esden/glasgow-addons/hardware/ram-pak/ram-pak-sch.pdf

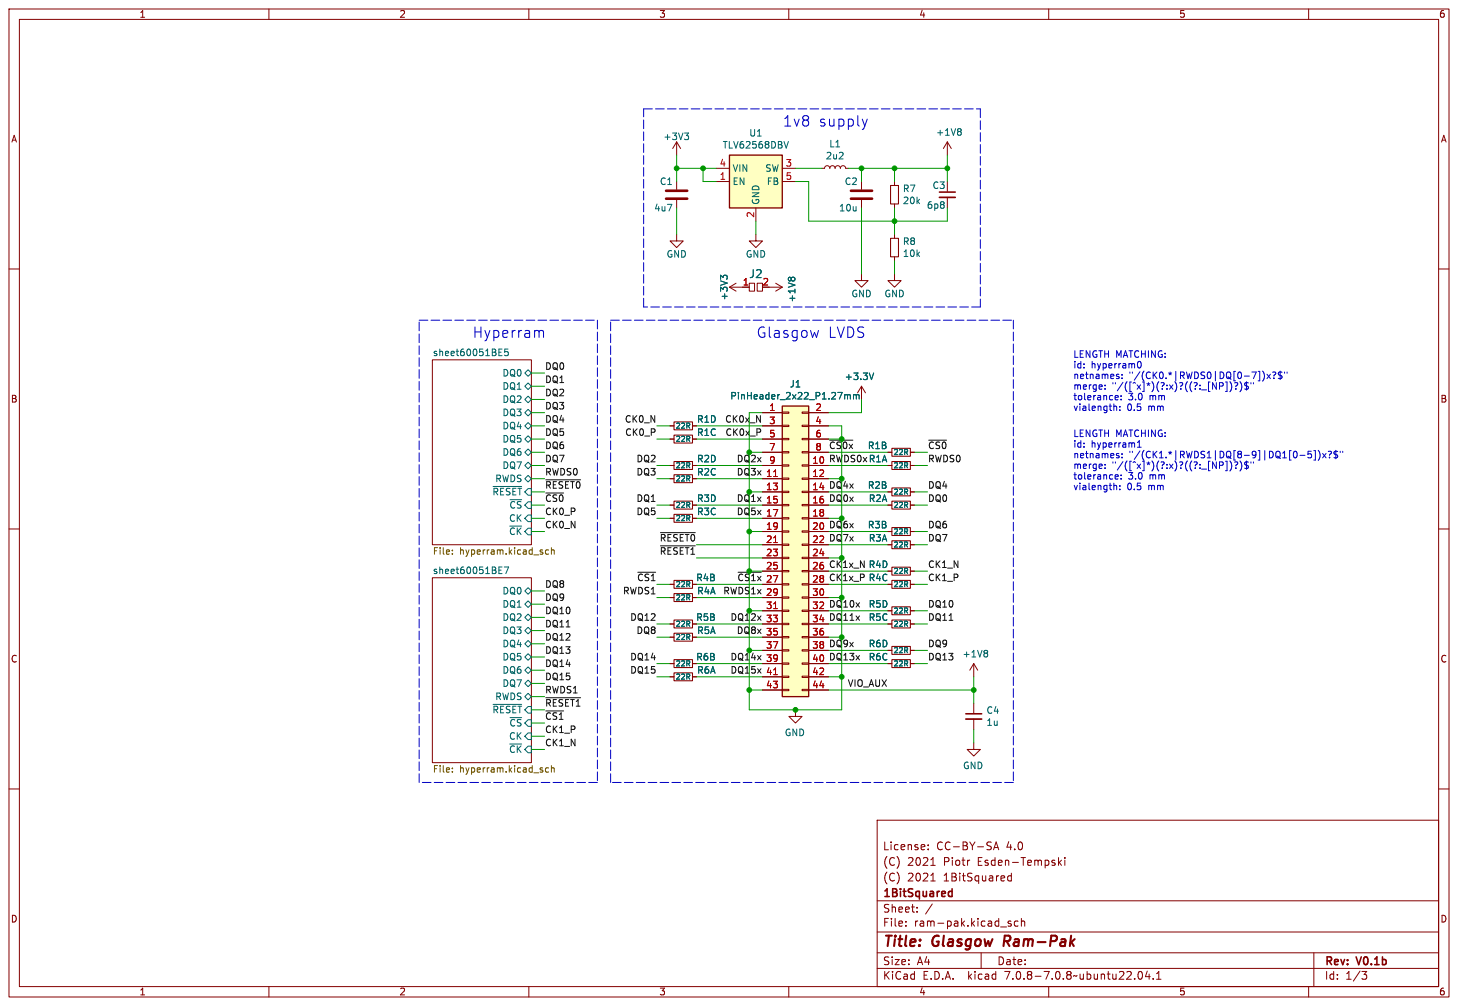
[picture p1: page 1]

File: ram-pak.kicad_sch Sheet: / 1BitSquared

Id: 1/3 Title: Glasgow Ram-Pak

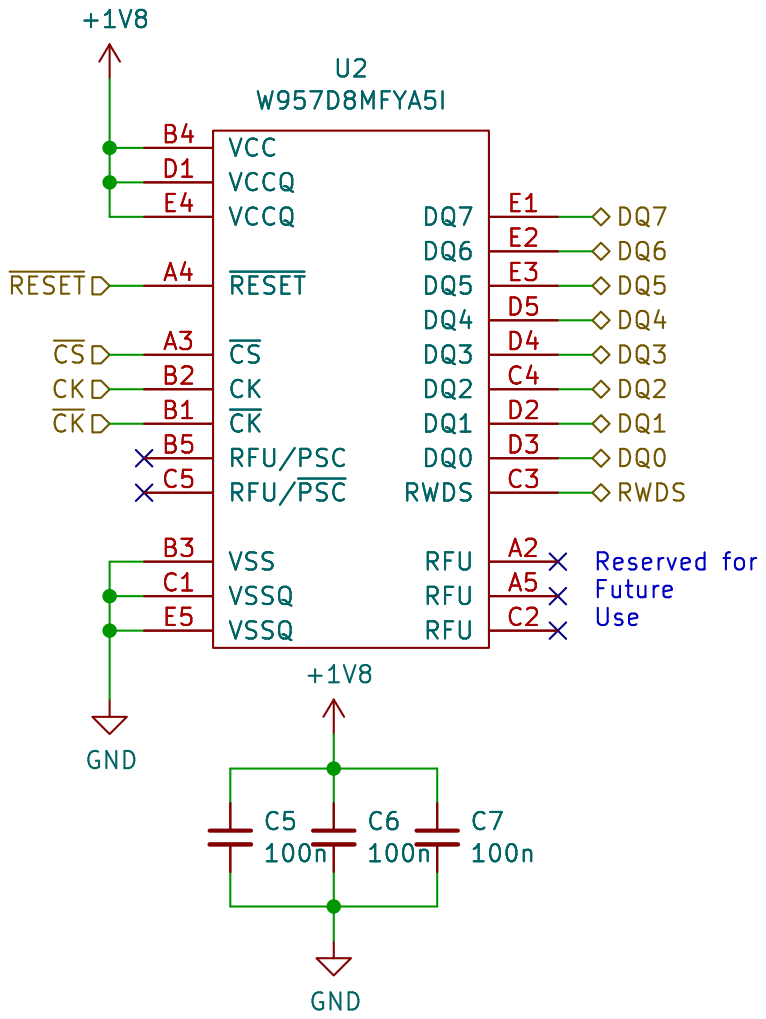
[picture p2: page 2]

Id: 2/3 Title: iCEBreaker PMOD - Hyperram

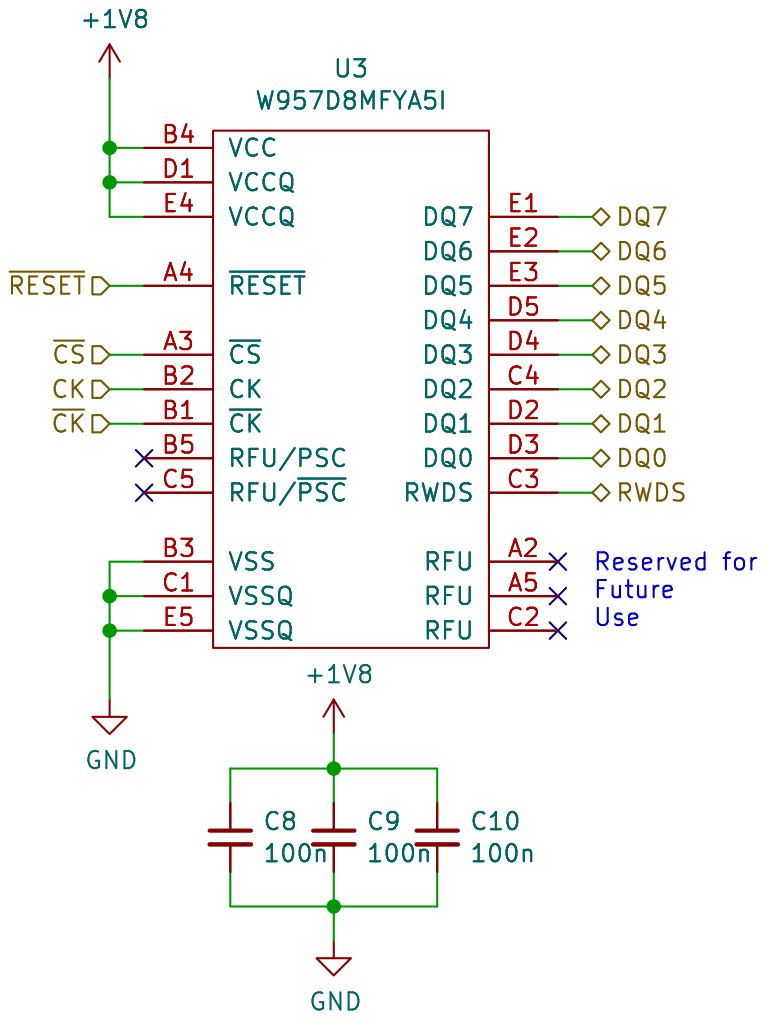
[picture p3: page 3]

Id: 3/3 Title: iCEBreaker PMOD - Hyperram
