esden/glasgow-addons/hardware/prom-addon/prom-addon-sch.pdf

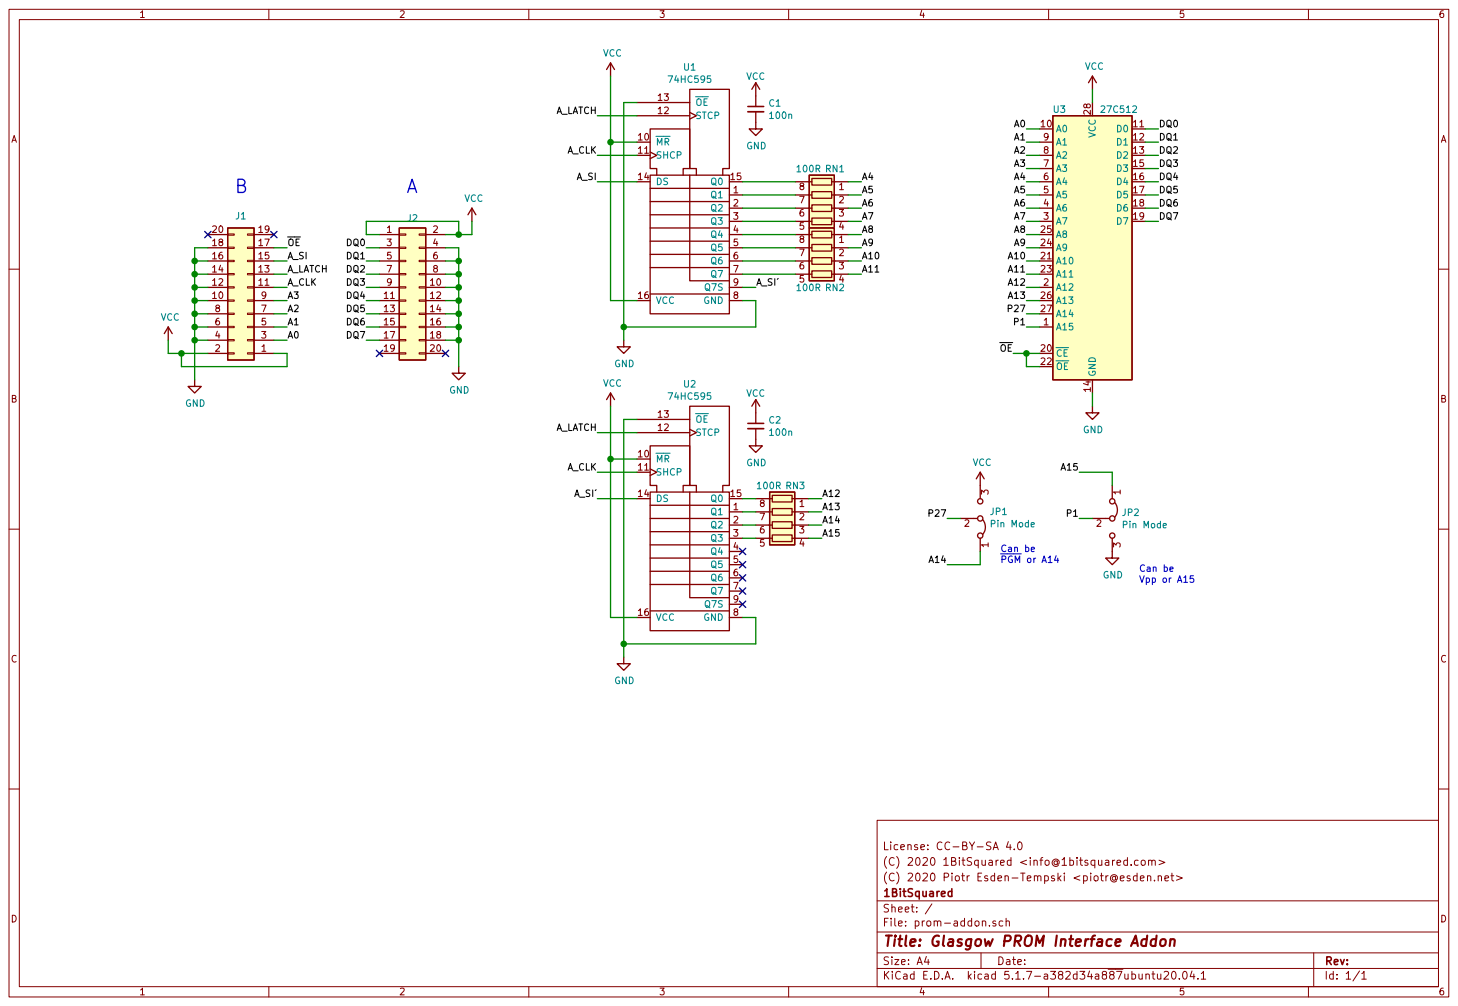
[picture p4: page 1]

License: CC-BY-SA 4.0 C2

(C) 2020 1BitSquared <info@1bitsquared.com>
(C) 2020 Piotr Esden-Tempski <piotr@esden.net>
File: prom-addon.sch Sheet: / 1BitSquared

Id: 1/1 Title: Glasgow PROM Interface Addon
