esden/glasgow-addons/hardware/ram-pak/ram-pak.kicad_pcb

## KiCad design hardware/ram-pak/ram-pak.kicad_pcb (2023-10-24)

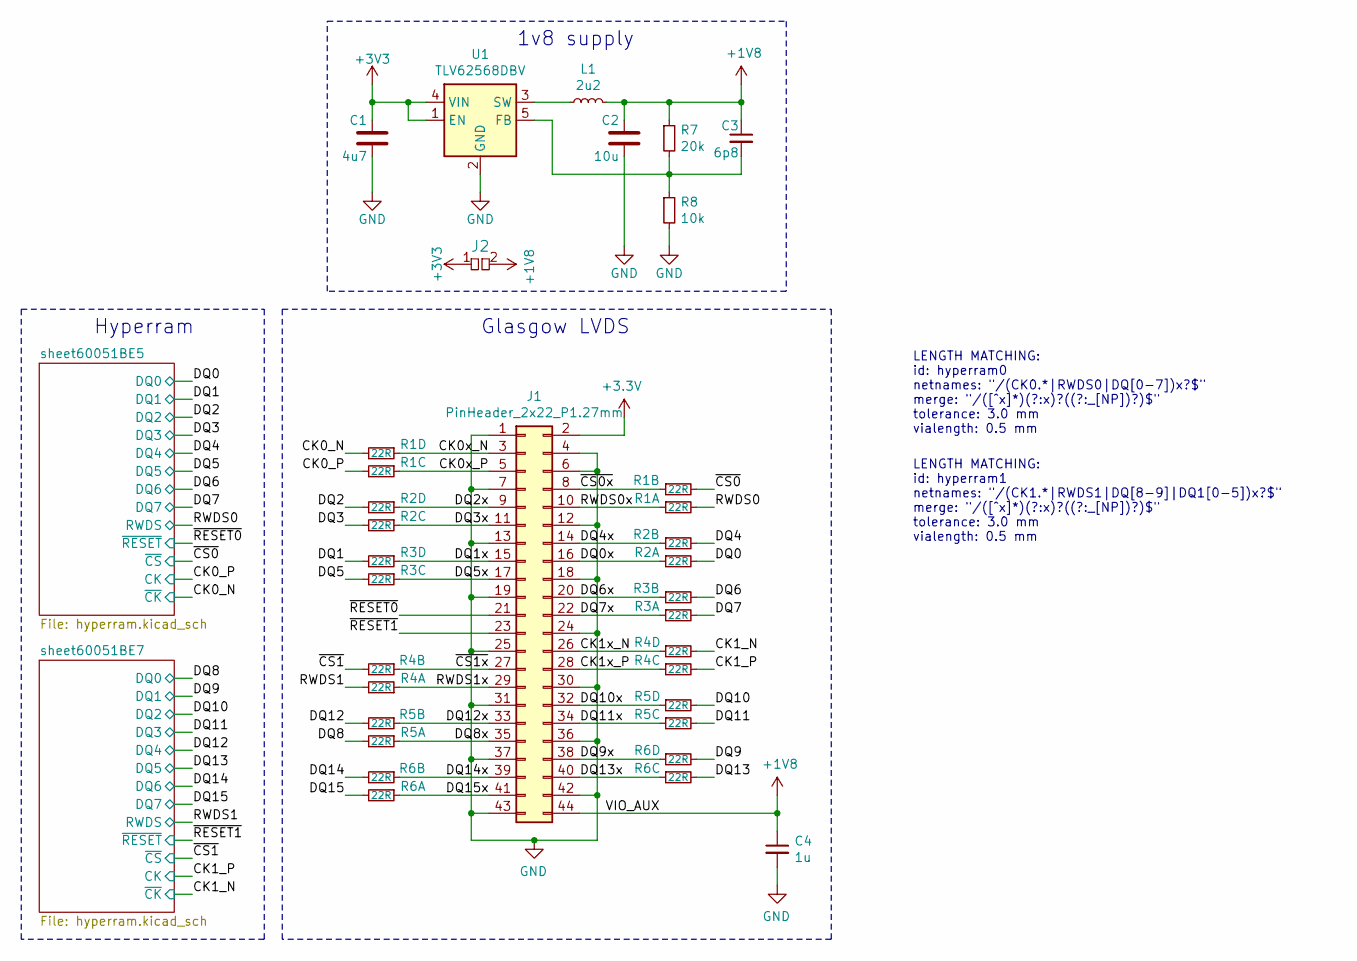
[picture p5: schematic ram-pak.kicad_sch, Glasgow Ram-Pak]

Parts:
C1: 4u7; C_0603
C2: 10u; C_0603
C3: 6p8; C_0402
C4: 1u; C_0402
J1: PinHeader_2x22_P1.27mm; PinSocket_2x22_P1.27mm_Vertical_Pass-Through__SMD; MPN FTS-122-01-L-DV
J2: pkl_jumper; J_0603
L1: 2u2; L_0805
R1, R2, R3, R4, R5, R6: 22R; R_Array_Convex_4x0402
R7: 20k; R_0402
R8: 10k; R_0402
U1: TLV62568DBV; SOT-23-5

Connections:
+1V8: C2.1, C3.1, C4.1, J1.44, J2.2, L1.1, R7.1; also elsewhere on the board
/CK0_N: R1.8; also elsewhere on the board
/CK0_P: R1.6; also elsewhere on the board
/CK0x_N: J1.3, R1.7
/CK0x_P: J1.5, R1.5
/CK1_N: R4.8; also elsewhere on the board
/CK1_P: R4.6; also elsewhere on the board
/CK1x_N: J1.26, R4.7
/CK1x_P: J1.28, R4.5
/DQ0: R2.2; also elsewhere on the board
/DQ0x: J1.16, R2.1
/DQ1: R3.8; also elsewhere on the board
/DQ1x: J1.15, R3.7
/DQ2: R2.8; also elsewhere on the board
/DQ2x: J1.9, R2.7
/DQ3: R2.6; also elsewhere on the board
/DQ3x: J1.11, R2.5
/DQ4: R2.4; also elsewhere on the board
/DQ4x: J1.14, R2.3
/DQ5: R3.6; also elsewhere on the board
/DQ5x: J1.17, R3.5
/DQ6: R3.4; also elsewhere on the board
/DQ6x: J1.20, R3.3
/DQ7: R3.2; also elsewhere on the board
/DQ7x: J1.22, R3.1
/DQ8: R5.2; also elsewhere on the board
/DQ8x: J1.35, R5.1
/DQ9: R6.8; also elsewhere on the board
/DQ9x: J1.38, R6.7
/DQ10: R5.8; also elsewhere on the board
/DQ10x: J1.32, R5.7
/DQ11: R5.6; also elsewhere on the board
/DQ11x: J1.34, R5.5
/DQ12: R5.4; also elsewhere on the board
/DQ12x: J1.33, R5.3
/DQ13: R6.6; also elsewhere on the board
/DQ13x: J1.40, R6.5
/DQ14: R6.4; also elsewhere on the board
/DQ14x: J1.39, R6.3
/DQ15: R6.2; also elsewhere on the board
/DQ15x: J1.41, R6.1
/RWDS0: R1.2; also elsewhere on the board
/RWDS0x: J1.10, R1.1
/RWDS1: R4.2; also elsewhere on the board
/RWDS1x: J1.29, R4.1
/~CS0x: J1.8, R1.3
/~CS0: R1.4; also elsewhere on the board
/~CS1x: J1.27, R4.3
/~CS1: R4.4; also elsewhere on the board
/~RESET0: J1.21; also elsewhere on the board
/~RESET1: J1.23; also elsewhere on the board
GND: C1.2, C2.2, C4.2, J1.1, J1.4, J1.6, J1.7, J1.12, J1.13, J1.18, J1.19, J1.24, J1.25, J1.30, J1.31, J1.36, J1.37, J1.42, J1.43, R8.2, U1.2 (GND); also elsewhere on the board
unnamed: C3.2, R7.2, R8.1, U1.5 (FB)
unnamed: L1.2, U1.3 (SW)

Notes on the sheet:
LENGTH MATCHING: id: hyperram0 netnames: "/(CK0.*|RWDS0|DQ[0-7])x?$" merge: "/([^x]*)(?:x)?((?:_[NP])?)$" tolerance: 3.0 mm vialength: 0.5 mm
Glasgow LVDS
LENGTH MATCHING: id: hyperram1 netnames: "/(CK1.*|RWDS1|DQ[8-9]|DQ1[0-5])x?$" merge: "/([^x]*)(?:x)?((?:_[NP])?)$" tolerance: 3.0 mm vialength: 0.5 mm
1v8 supply
Hyperram

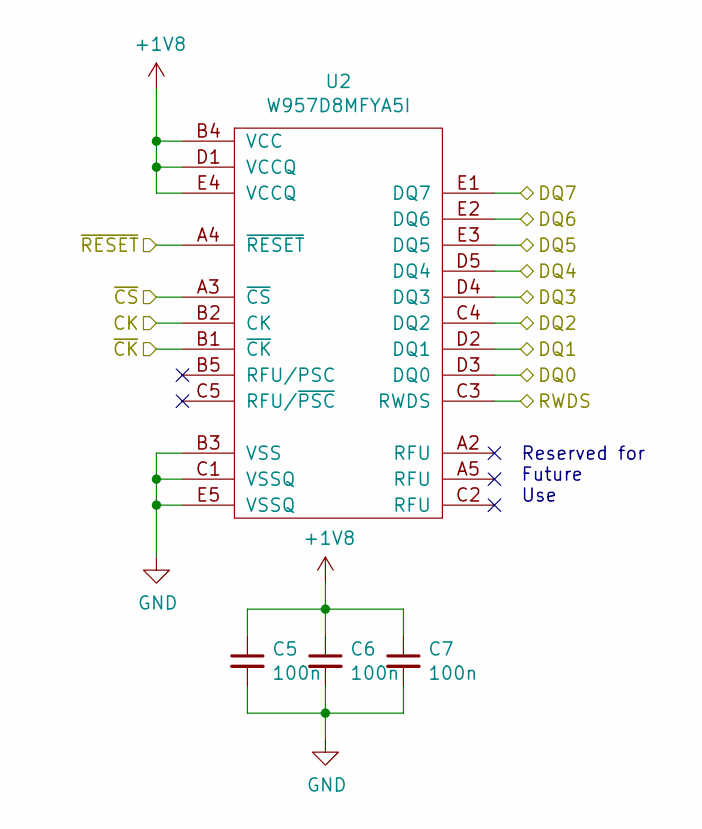
[picture p6: schematic hyperram.kicad_sch, iCEBreaker PMOD - Hyperram]

Parts:
C5, C6, C7: 100n; C_0402
U2: W957D8MFYA5I; BGA-24_5x5_6.0x8.0mm

Connections:
+1V8: C5.1, C6.1, C7.1, U2.B4 (VCC), U2.D1 (VCCQ), U2.E4 (VCCQ); also elsewhere on the board
/CK0_N: U2.B1 (~CK); also elsewhere on the board
/CK0_P: U2.B2 (CK); also elsewhere on the board
/DQ0: U2.D3 (DQ0); also elsewhere on the board
/DQ1: U2.D2 (DQ1); also elsewhere on the board
/DQ2: U2.C4 (DQ2); also elsewhere on the board
/DQ3: U2.D4 (DQ3); also elsewhere on the board
/DQ4: U2.D5 (DQ4); also elsewhere on the board
/DQ5: U2.E3 (DQ5); also elsewhere on the board
/DQ6: U2.E2 (DQ6); also elsewhere on the board
/DQ7: U2.E1 (DQ7); also elsewhere on the board
/RWDS0: U2.C3 (RWDS); also elsewhere on the board
/~CS0: U2.A3 (~CS); also elsewhere on the board
/~RESET0: U2.A4 (~RESET); also elsewhere on the board
GND: C5.2, C6.2, C7.2, U2.B3 (VSS), U2.C1 (VSSQ), U2.E5 (VSSQ); also elsewhere on the board

Parts of its further copies:
C8, C9, C10: 100n; C_0402
U3: W957D8MFYA5I; BGA-24_5x5_6.0x8.0mm

Connections of its further copies:
+1V8: C8.1, C9.1, C10.1, U3.B4 (VCC), U3.D1 (VCCQ), U3.E4 (VCCQ); also elsewhere on the board
/CK1_N: U3.B1 (~CK); also elsewhere on the board
/CK1_P: U3.B2 (CK); also elsewhere on the board
/DQ8: U3.D3 (DQ0); also elsewhere on the board
/DQ9: U3.D2 (DQ1); also elsewhere on the board
/DQ10: U3.C4 (DQ2); also elsewhere on the board
/DQ11: U3.D4 (DQ3); also elsewhere on the board
/DQ12: U3.D5 (DQ4); also elsewhere on the board
/DQ13: U3.E3 (DQ5); also elsewhere on the board
/DQ14: U3.E2 (DQ6); also elsewhere on the board
/DQ15: U3.E1 (DQ7); also elsewhere on the board
/RWDS1: U3.C3 (RWDS); also elsewhere on the board
/~CS1: U3.A3 (~CS); also elsewhere on the board
/~RESET1: U3.A4 (~RESET); also elsewhere on the board
GND: C8.2, C9.2, C10.2, U3.B3 (VSS), U3.C1 (VSSQ), U3.E5 (VSSQ); also elsewhere on the board

Notes on the sheet:
Reserved for Future Use

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
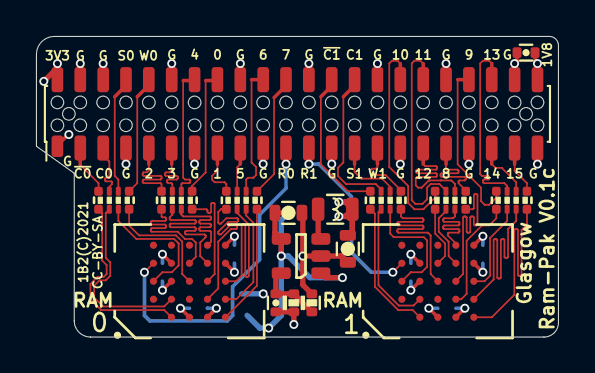
[picture p7: board ram-pak.kicad_pcb from above]

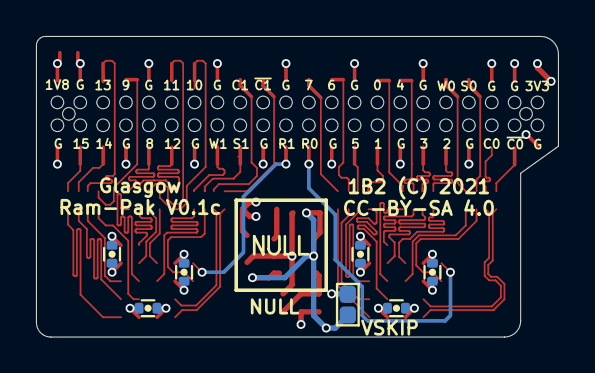
[picture p8: board ram-pak.kicad_pcb from below]

Board: 4 copper layers, 29.0 x 16.7 mm, 24 parts (7 on the bottom side), 55 nets.
