esden/glasgow-addons/hardware/prom-addon/prom-addon.kicad_pcb

## KiCad design hardware/prom-addon/prom-addon.kicad_pcb (2021-01-18)

Schematic: prom-addon.sch, Glasgow PROM Interface Addon

Parts:
C1, C2: 100n; C_0402
J1, J2: Conn_02x10_Odd_Even; PinSocket_2x10_P2.54mm_Vertical
JP1, JP2: Pin Mode; PinHeader_1x03_P2.54mm_Vertical
RN1, RN2, RN3: 33R; R_Array_Convex_4x0402
U1, U2: 74HC595; DHVQFN-16_2.5x3.5mm_Pitch0.5mm
U3: 27C512; DIP-28_W15.24mm

Connections:
/A0: J1.3, U3.10 (A0)
/A1: J1.5, U3.9 (A1)
/A2: J1.7, U3.8 (A2)
/A3: J1.9, U3.7 (A3)
/A4: RN1.1 (R1.1), U3.6 (A4)
/A5: RN1.2 (R2.1), U3.5 (A5)
/A6: RN1.3 (R3.1), U3.4 (A6)
/A7: RN1.4 (R4.1), U3.3 (A7)
/A8: RN2.1 (R1.1), U3.25 (A8)
/A9: RN2.2 (R2.1), U3.24 (A9)
/A10: RN2.3 (R3.1), U3.21 (A10)
/A11: RN2.4 (R4.1), U3.23 (A11)
/A12: RN3.1 (R1.1), U3.2 (A12)
/A13: RN3.2 (R2.1), U3.26 (A13)
/A14: JP1.1 (A), RN3.3 (R3.1)
/A15: JP2.1 (A), RN3.4 (R4.1)
/A_CLK: J1.11, U1.11, U2.11
/A_LATCH: J1.13, U1.12, U2.12
/A_SI: J1.15, U1.14
/A_SI´: U1.9, U2.14
/DQ0: J2.3, U3.11 (D0)
/DQ1: J2.5, U3.12 (D1)
/DQ2: J2.7, U3.13 (D2)
/DQ3: J2.9, U3.15 (D3)
/DQ4: J2.11, U3.16 (D4)
/DQ5: J2.13, U3.17 (D5)
/DQ6: J2.15, U3.18 (D6)
/DQ7: J2.17, U3.19 (D7)
/P1: JP2.2 (C), U3.1 (A15)
/P27: JP1.2 (C), U3.27 (A14)
/~OE: J1.17, U3.20 (~CE), U3.22 (~OE)
GND: C1.2, C2.2, J1.4, J1.6, J1.8, J1.10, J1.12, J1.14, J1.16, J1.18, J2.4, J2.6, J2.8, J2.10, J2.12, J2.14, J2.16, J2.18, JP2.3 (B), U1.8, U1.13, U1.17, U2.8, U2.13, U2.17, U3.14 (GND)
unnamed: RN1.5 (R4.2), U1.3
unnamed: RN1.6 (R3.2), U1.2
unnamed: RN1.7 (R2.2), U1.1
unnamed: RN1.8 (R1.2), U1.15
unnamed: RN2.5 (R4.2), U1.7
unnamed: RN2.6 (R3.2), U1.6
unnamed: RN2.7 (R2.2), U1.5
unnamed: RN2.8 (R1.2), U1.4
unnamed: RN3.5 (R4.2), U2.3
unnamed: RN3.6 (R3.2), U2.2
unnamed: RN3.7 (R2.2), U2.1
unnamed: RN3.8 (R1.2), U2.15
VCC: C1.1, C2.1, J1.1, J1.2, J2.1, J2.2, JP1.3 (B), U1.10, U1.16, U2.10, U2.16, U3.28 (VCC)

Notes on the sheet:
Can be ~PGM~ or A14
Can be Vpp or A15

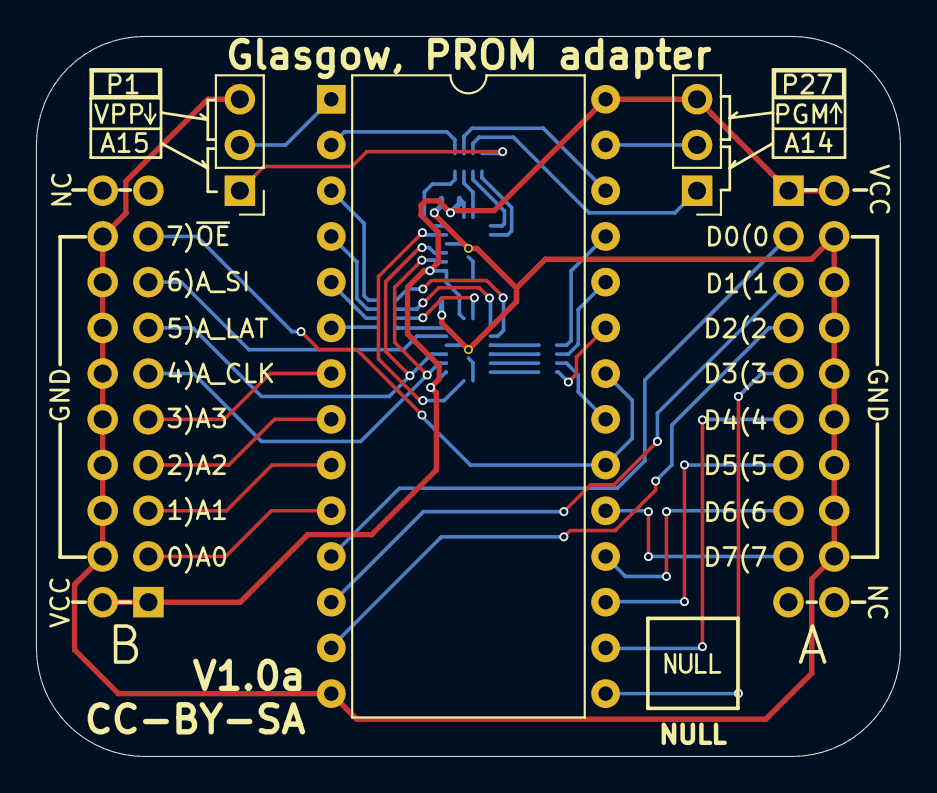
[picture p9: board prom-addon.kicad_pcb from above]

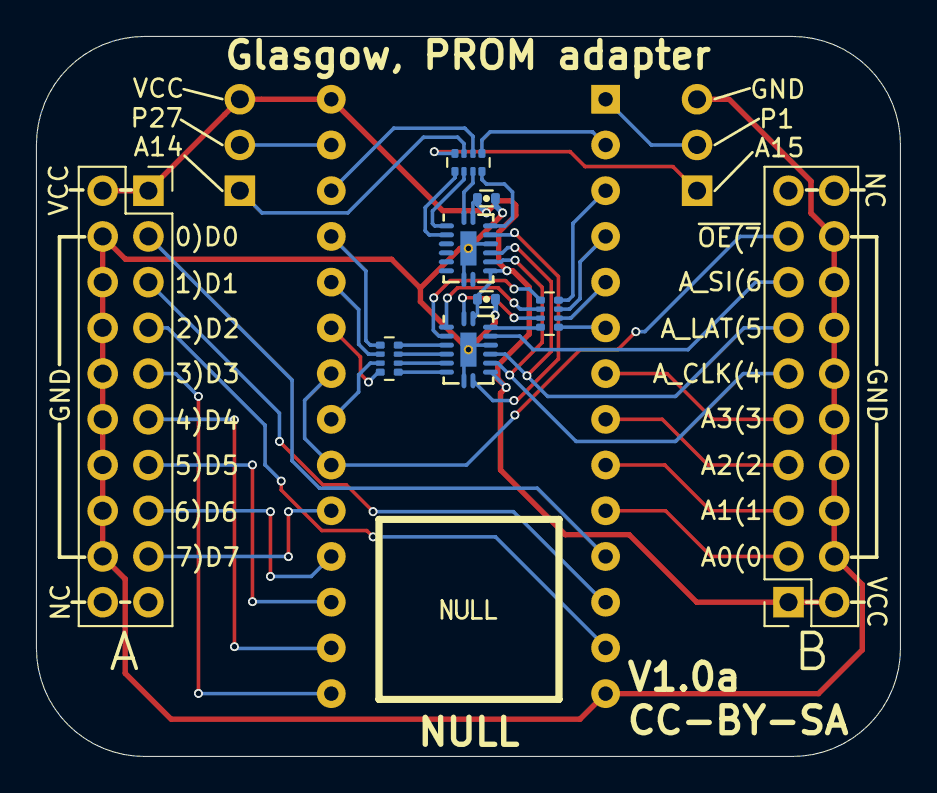
[picture p10: board prom-addon.kicad_pcb from below]

Board: 2 copper layers, 48.0 x 40.0 mm, 12 parts (9 on the bottom side), 45 nets.
