esden/glasgow-addons/(commit log)

2020-08-26 prom interface addon initial commit.
    [prom-addon.kicad_pcb, prom-addon.sch]
2020-09-03 The ROM reader addon schematic finished.
    We are pretty much ready for layout. Status as of @esden twitch stream
    on 2020-09-01.
    [prom-addon.kicad_pcb, prom-addon.sch]
2020-09-30 prom: Routed the first version of the board.
    [prom-addon.kicad_pcb, prom-addon.sch]
2020-10-14 Replaced supply fills with point to point routing.
    Will look better in afterdark. ;)
    [prom-addon.kicad_pcb, prom-addon.sch]
2020-10-15 Silkscreen minor fixes.
    [prom-addon.kicad_pcb]
2020-10-27 Added schematic pdf.
2021-01-18 prom: Added silkscreen legend. Bumped version.
    [prom-addon.kicad_pcb, prom-addon.sch]
2021-01-27 Initial commit of the RAM Pak for the LVDS connector.
    [hyperram.sch, ram-pak.kicad_pcb, ram-pak.sch]
2021-01-27 Added ram-pak schematic pdf.
2021-01-31 Added missing 3d models.
    [ram-pak.kicad_pcb, ram-pak.sch]
2021-02-10 Ram-Pak: Routed and length matched.
    [ram-pak.kicad_pcb, ram-pak.sch]
2021-02-10 Ram-Pak: Updated schematic PDF plot.
2021-02-13 ram-pak: silkscreen improvements.
    [hyperram.sch, ram-pak.kicad_pcb, ram-pak.sch]
2021-02-13 ram-pak: Some more silkscreen work.
    [ram-pak.kicad_pcb]
2021-02-13 ram-pak: Fab layer placement plan cleanup.
    [ram-pak.kicad_pcb]
2021-02-13 ram-pak: Extended and updated BOM information.
    [hyperram.sch, ram-pak.kicad_pcb, ram-pak.sch]
2021-02-16 ram-pak: Removed back pads, added VSKIP bumped version.
    * Removed the back side connector mounting pads. (only needed for the
    first prototype using 1.6mm thick pcb)
    * Added VSKIP that allows the use of 3v3 RAM chips.
    * Bumped version to V0.1b
    [ram-pak.kicad_pcb, ram-pak.sch]
2021-02-16 ram-pak: VSKIP jumper position adjusted.
    [ram-pak.kicad_pcb]
2021-02-16 ram-pak: Cleaned up fab layer.
    [ram-pak.kicad_pcb]
2021-07-05 ram-pak: Increased pad hole gap for improved assembly.
    [ram-pak.kicad_pcb, ram-pak.sch]
2021-07-05 ram-pak: Moved some of the passives and traces from the board edge.
    This should make it slightly more mechanically robust and easier to
    assemble.
    [ram-pak.kicad_pcb]
2021-07-05 ram-pak: Some VREG routing cleanup.
    [ram-pak.kicad_pcb]
2021-07-29 ram-pak: Increased hole trace spacing to 0.2mm.
    To reliably manufacture the ram-pak the traces need to be at least 0.2mm
    from the NPTH pin header holes. To accomplish that we had to find a
    different way to lengthmatch the traces.
    Bumped version to 0.1c.
    [ram-pak.kicad_pcb, ram-pak.sch]
2021-07-29 ram-pak: Slightly increased pad gap for the r-paks.
    If we can it is good to get solder mask bridges on the r-paks.
    [ram-pak.kicad_pcb]
2021-07-29 ram-pak: Some silkscreen cleanup.
    [ram-pak.kicad_pcb]
2023-10-24 Updated ram-pak files to KiCad V7.
    [hyperram.kicad_sch, ram-pak.kicad_pcb, ram-pak.kicad_sch, ram-pak.sch]
2023-10-24 Added KiCad V7 gitignores.
