esden/glasgow-addons/(notices)

Notices in the files:
hardware/ram-pak/ram-pak.kicad_pcb:
(C) 2021 1BitSquared
(C) 2021 Piotr Esden-Tempski
1B2 (C) 2021
CC-BY-SA 4.0
CC-BY-SA
hardware/prom-addon/prom-addon.sch:
(C) 2020-2021 Piotr Esden-Tempski
(C) 2020-2021 1BitSquared
